ryood/VCVS_DCF_Shield/VCVS Q Control Test/P1100518.jpg

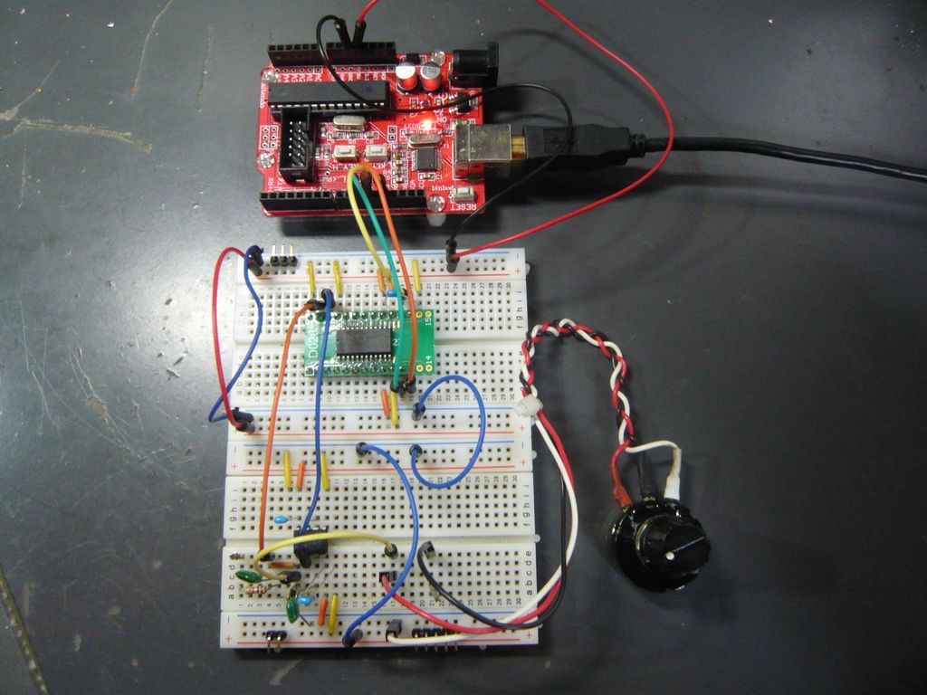
VCVS Q Control Test/P1100518.jpg
