ryood/VCVS_DCF_Shield/eagle/DCF_AD8403_Shield_brd.png

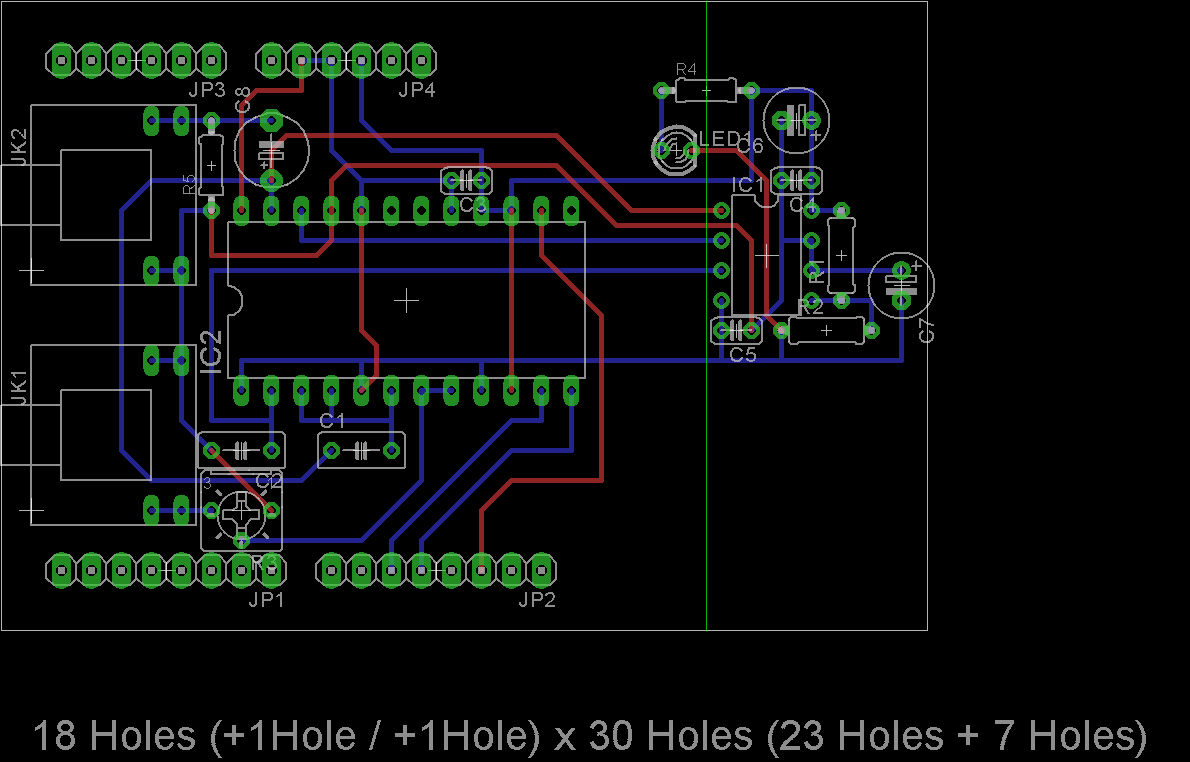
eagle/DCF_AD8403_Shield_brd.png
