ryood/VCVS_DCF_Shield/VCVS Q Control Test/VCVS Cutoff-control.asc

C1: cap; 0.01uF
C2: cap; 0.01uF
R1: res; {Rfc}
R2: res; {Rfc}
Rq1: res; 1f
Rq2: res; 100k
U1: UniversalOpamp2
V1: voltage; ""; AC 1
V2: voltage; 5V
V3: voltage; -5V
Named nets: 0, VCC, VEE, OUT, IN
.step param Rfc 1k 101k 10k
.ac oct 20 100 1Meg
