ryood/VCVS_DCF_Shield/VCVS Q Control Test/VCVS Q-control.asc

C1: cap; 0.01uF
C2: cap; 0.01uF
R1: res; 10k
R2: res; 10k
Rq1: res; {RQ}
Rq2: res; {100k-RQ}
U1: UniversalOpamp2
V1: voltage; ""; AC 1
V2: voltage; 5V
V3: voltage; -5V
Named nets: 0, VCC, VEE, OUT, IN
.step param RQ list 1f 30k 60k 65k 66k 67k 68k
.ac oct 20 100 1Meg
