ryood/VCVS_DCF_Shield/VCVS Q Control Test/VCVS.asc

C1: cap; 0.01uF
C2: cap; 0.01uF
R1: res; 10k
R2: res; 10k
U1: UniversalOpamp2
V1: voltage; ""; AC 1
V2: voltage; 5V
V3: voltage; -5V
Named nets: 0, VCC, VEE, OUT, IN
.ac oct 20 100 1Meg
