ryood/VCVS_DCF_Shield/(list of files, drawings)

Other design files:
fritzing/DCF_AD8403_Shield.fzz
fritzing/DCF_AD8403_Shield_5VSupply.fzz
VCVS Q Control Test/AD8403_Test.fzz
VCVS Q Control Test/AD8403_VCF.fzz
VCVS Q Control Test/AD8403_VCF_Cutoff_Q_Control.fzz
