ryood/VCVS_DCF_Shield/eagle/DCF_AD8403_Shield.brd

## EAGLE design eagle/DCF_AD8403_Shield.brd (2016-04-16)

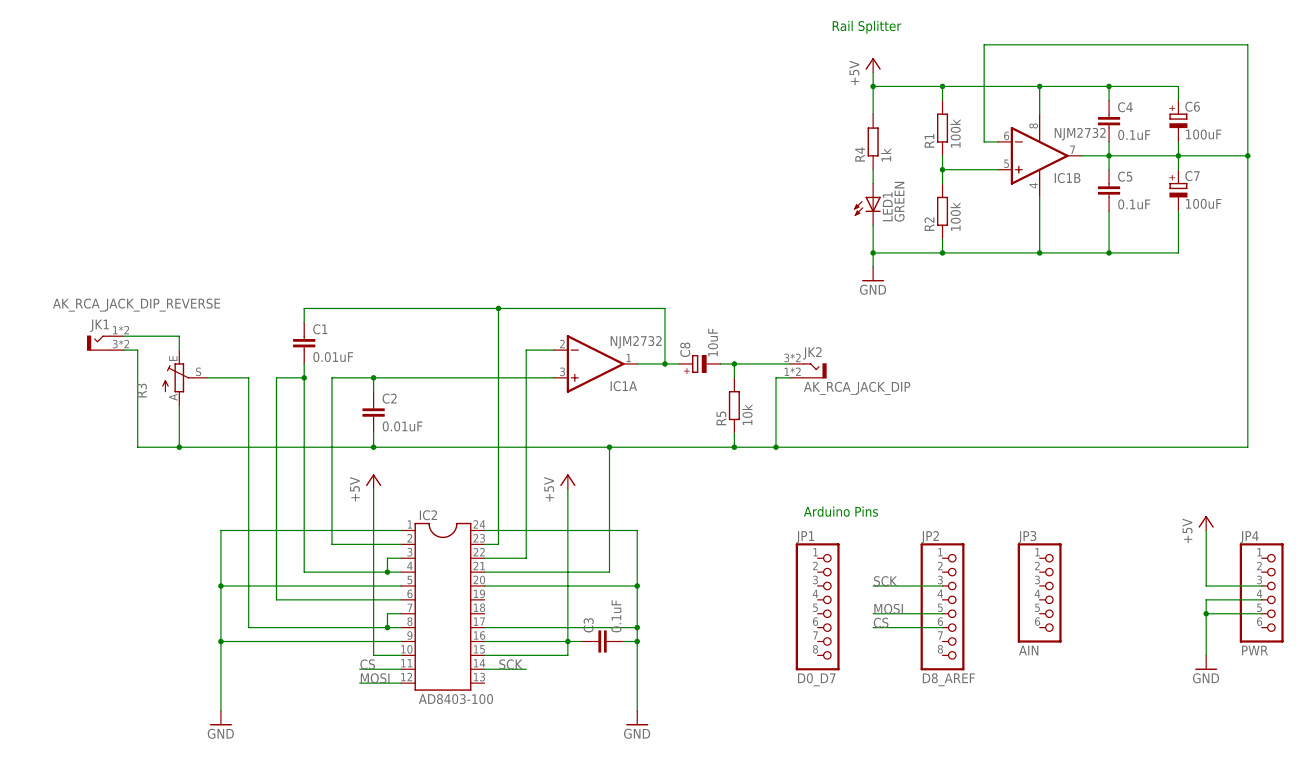
[picture p4: schematic DCF_AD8403_Shield.sch]

Parts:
C1, C2: 0.01uF; C050-030X075
C3, C4, C5: 0.1uF; C025-024X044
C6, C7: 100uF; E2,5-6
C8: 10uF; E5-6
IC1: NJM2732; DIL08
IC2: AD8403-100; DIL24-6
JK1: AK_RCA_JACK_DIP_REVERSE; AK_RCA_JACK_DIP
JK2: AK_RCA_JACK_DIP
JP1: D0_D7; 1X08
JP2: D8_AREF; 1X08
JP3: AIN; 1X06
JP4: PWR; 1X06
LED1: GREEN; LED3MM
R1, R2: 100k; 0207/7
R3: TRIM_EU-B25P; B25P
R4: 1k; 0204/7
R5: 10k; 0204/7

Connections:
+5V: C3.1, C4.1, C6.+, IC1.8 (V+), IC2.10, IC2.15, IC2.16, JP4.3, R1.2, R4.2
BYPASS: IC2.7, IC2.8, R3.S
CS: IC2.11, JP2.6
FILTERED: C1.1, C8.+, IC1.1 (OUT), IC2.23
GND: C3.2, C5.2, C7.-, IC1.4 (V-), IC2.1, IC2.5, IC2.9, IC2.17, IC2.20, IC2.24, JP4.4, JP4.5, LED1.K (C), R2.1
MOSI: IC2.12, JP2.5
unnamed: IC1.2 (-IN), IC2.22
unnamed: LED1.A, R4.1
unnamed: C8.-, JK2.3 (T), JK2.4 (T), R5.2
unnamed: IC1.5 (+IN), R1.1, R2.2
unnamed: C1.2, IC2.3, IC2.4, IC2.6
unnamed: JK1.1 (T), JK1.2 (T), R3.E
unnamed: C2.1, IC1.3 (+IN), IC2.2
unnamed: C2.2, C4.2, C5.1, C6.-, C7.+, IC1.6 (-IN), IC1.7 (OUT), IC2.21, JK1.3 (S), JK1.4 (S), JK2.1 (S), JK2.2 (S), R3.A, R5.1
SCK: IC2.14, JP2.3

Notes on the sheet:
Rail Splitter
Arduino Pins

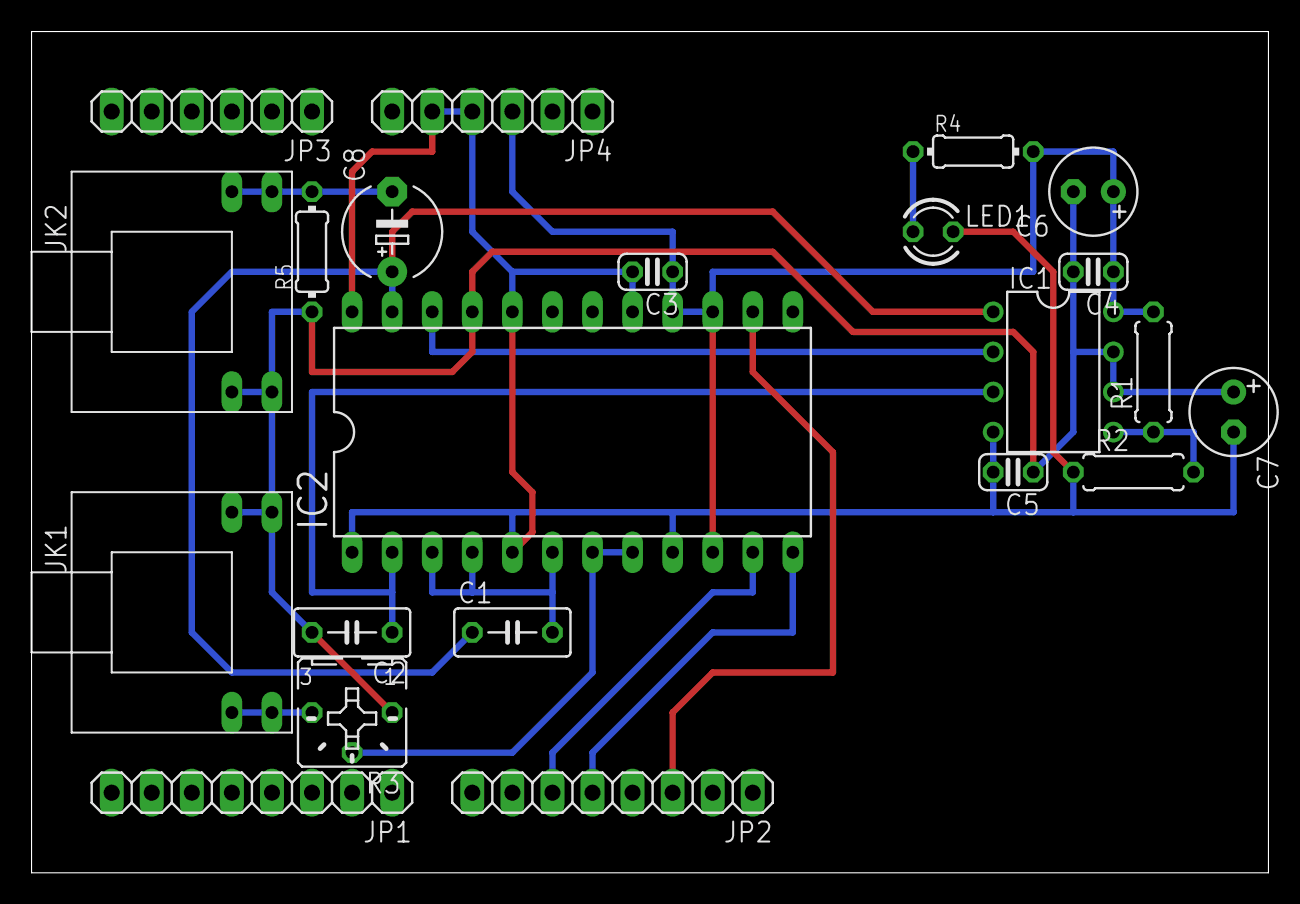
[picture p5: board DCF_AD8403_Shield.brd from above]

Board: 2 copper layers, 78.4 x 53.3 mm, 22 parts (0 on the bottom side), 15 nets.
