ryood/VCVS_DCF_Shield/VCVS Q Control Test/AD8403_Test_ブレッドボード.png

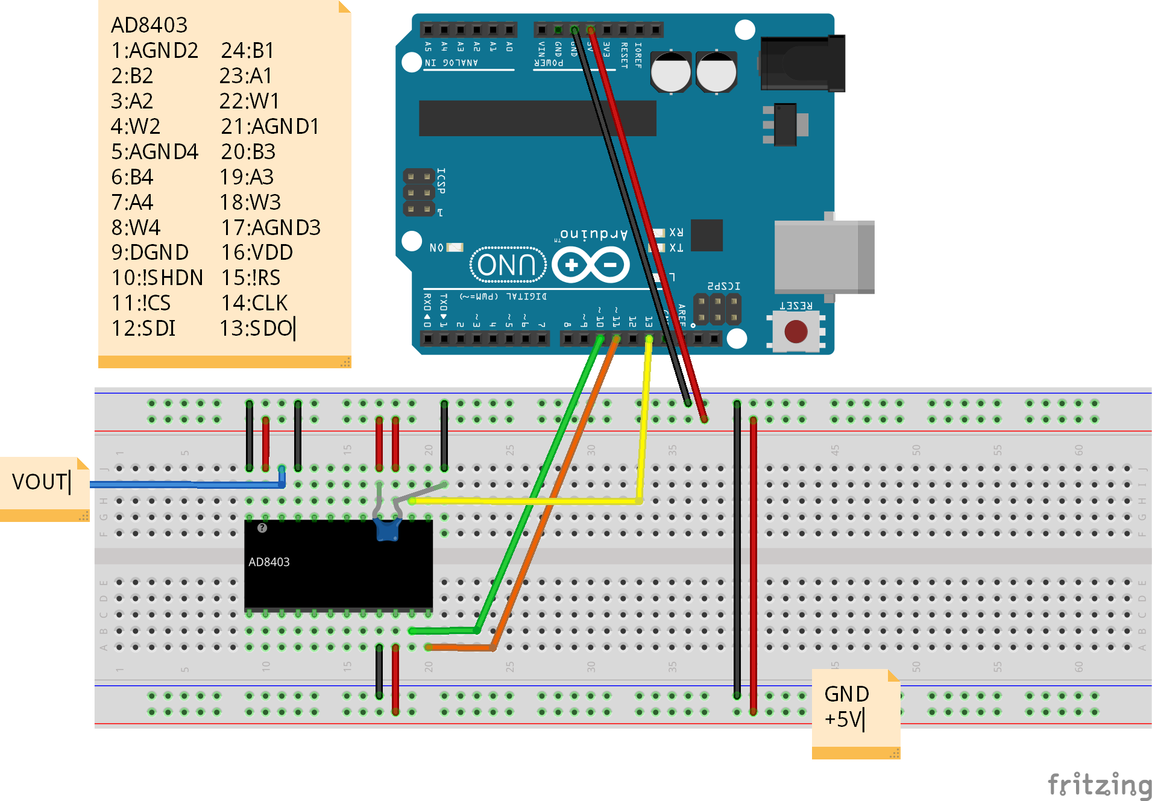
VCVS Q Control Test/AD8403_Test_ブレッドボード.png
