ryood/VCVS_DCF_Shield/VCVS Q Control Test/AD8403_VCF_Cutoff_Q_Control_ブレッドボード.png

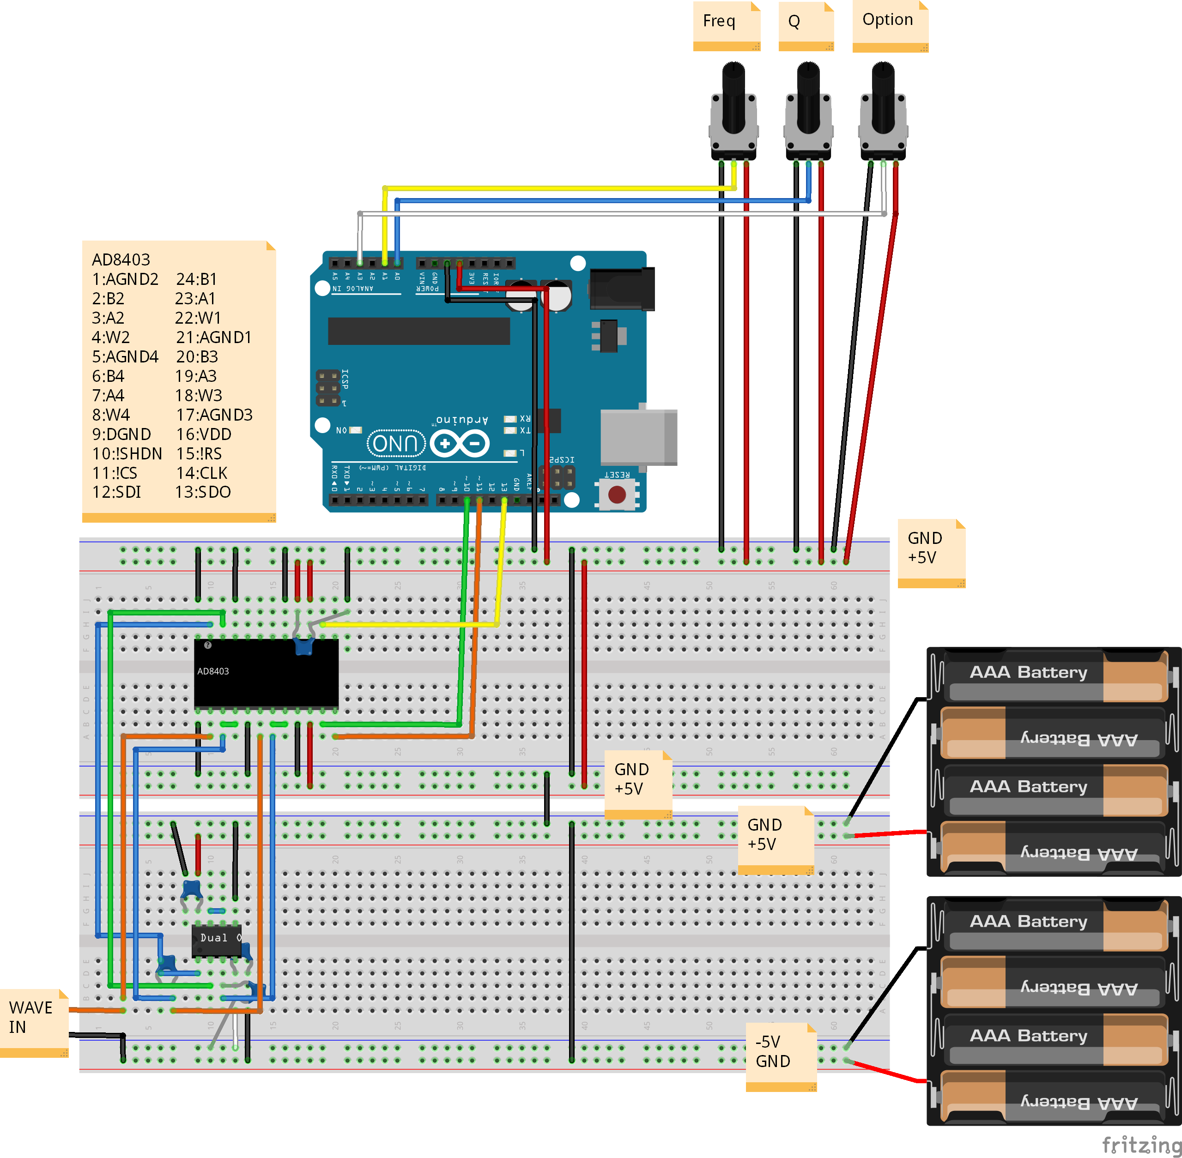
VCVS Q Control Test/AD8403_VCF_Cutoff_Q_Control_ブレッドボード.png
