ryood/VCVS_DCF_Shield/VCVS Q Control Test/AD8403_VCF_ブレッドボード.png

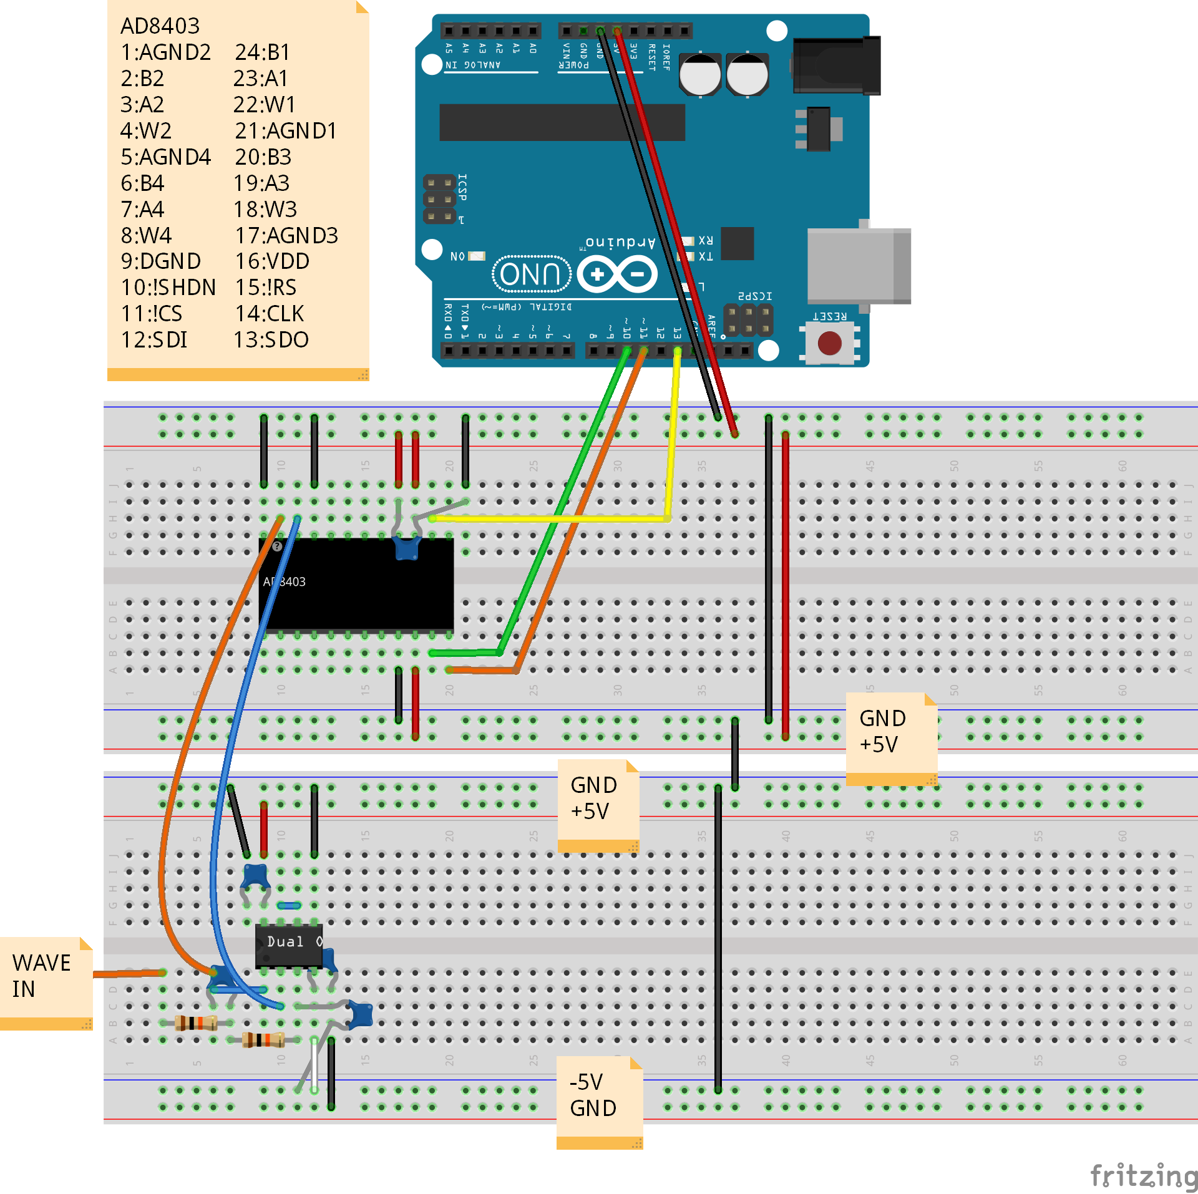
VCVS Q Control Test/AD8403_VCF_ブレッドボード.png
