ryood/VCVS_DCF_Shield/VCVS Q Control Test/VCVS Cutoff Control_ac.png

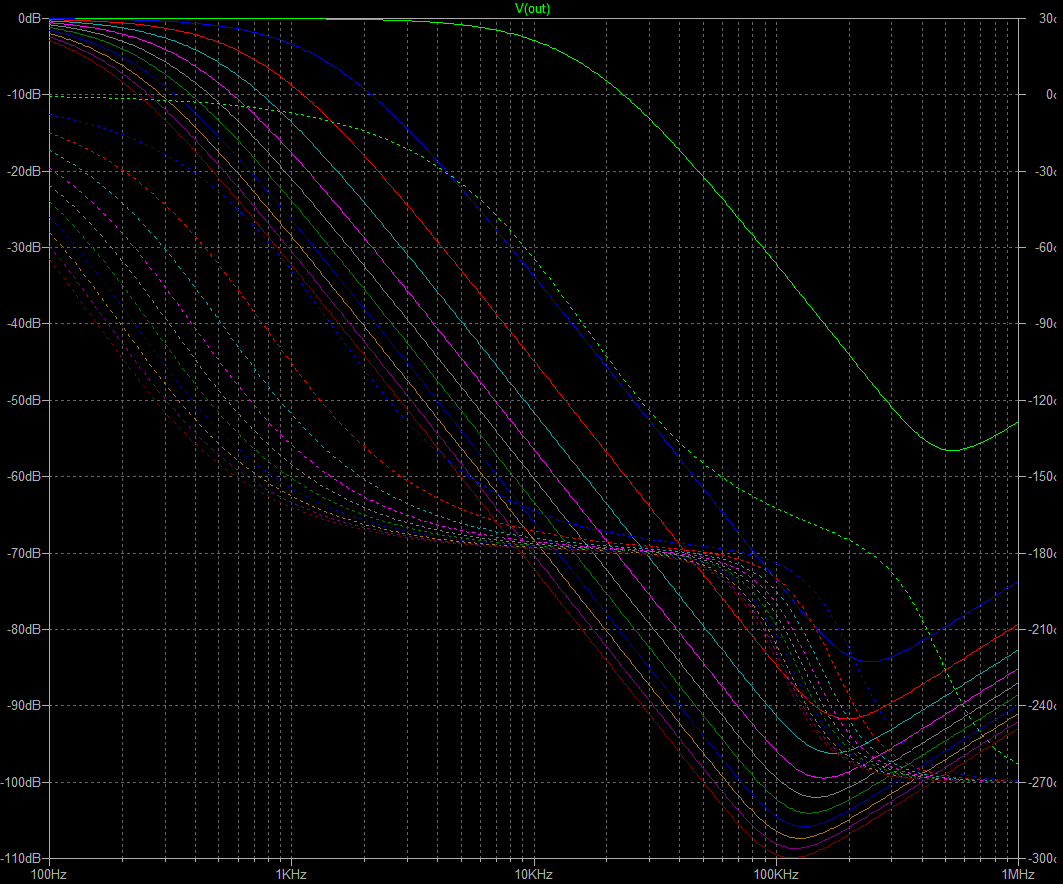
VCVS Q Control Test/VCVS Cutoff Control_ac.png
