ryood/VCVS_DCF_Shield/VCVS Q Control Test/VCVS-Q-Control_sim.png

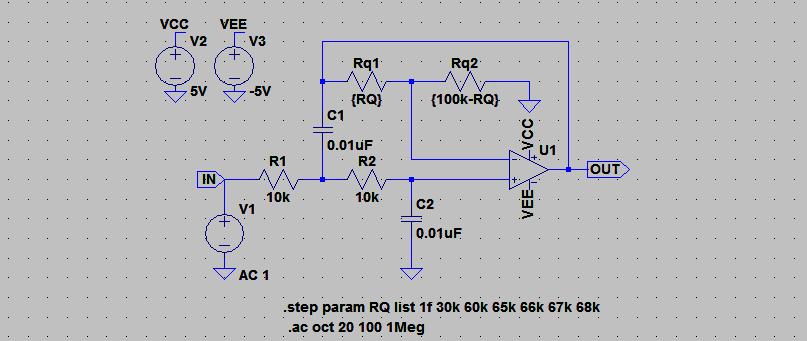
VCVS Q Control Test/VCVS-Q-Control_sim.png
