ryood/VCVS_DCF_Shield/(commit log)

2016-04-04 基板図仮配線
    [DCF_AD8403_Shield.brd, DCF_AD8403_Shield.sch]
2016-04-07 Update Eagle Files
    [DCF_AD8403_Shield.brd, DCF_AD8403_Shield.sch]
2016-04-07 Add: output AC Coupling
    [DCF_AD8403_Shield.brd, DCF_AD8403_Shield.sch]
2016-04-07 Remove: Decoupling Capacitor of OPAMP
    [DCF_AD8403_Shield.brd, DCF_AD8403_Shield.sch]
2016-04-10 Add: OPAMP Decoupling Capacitor
    [DCF_AD8403_Shield.brd, DCF_AD8403_Shield.sch]
2016-04-13 配線完了
    [DCF_AD8403_Shield.brd, DCF_AD8403_Shield.sch]
2016-04-13 Add: Input trim pot
    [DCF_AD8403_Shield.brd, DCF_AD8403_Shield.sch]
2016-04-16 基板図を修正
    [DCF_AD8403_Shield.brd]
2016-04-16 fritzingファイルを追加
    [DCF_AD8403_Shield.fzz, DCF_AD8403_Shield_5VSupply.fzz]
2016-04-16 テスト表を追加
    [DCF_AD8403_Shield_20160411.xlsx]
2016-04-16 Add: VCVS Q Control Test files
    [AD8403_Test.fzz, AD8403_VCF.fzz, AD8403_VCF_Cutoff_Q_Control.fzz]
2016-04-16 Add: Arduino Sketch
2016-04-16 Add: Schematic & Board PNG files
